JoeTouchman/JoebotHand/hardware/forearm_v3.stl

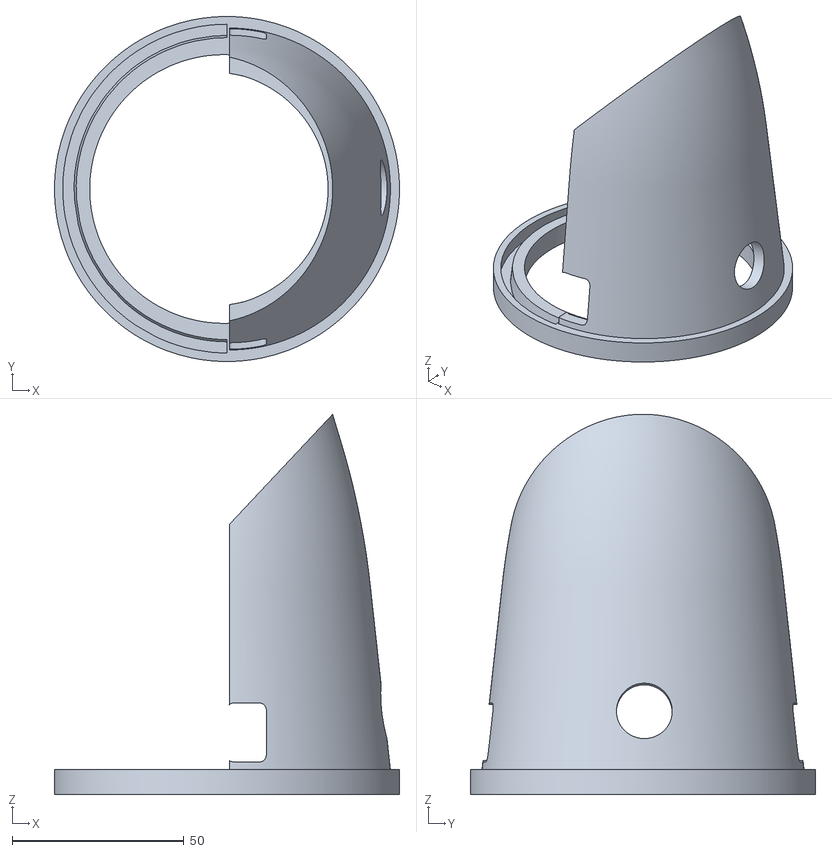
[picture p8: CAD file, 2026-11-10]
hardware/forearm_v3.stl
100.3 x 100.3 x 110.6
