JoeTouchman/JoebotHand/(commit log)

2026-09-15 Uno robotic hand: servo sketch, Python controllers, calibration
    Original Arduino Uno version of the hand. hand_servos.ino drives five
    servos from a line-based serial protocol; hand_control.py (Qt, webcam
    tracking, rock-paper-scissors) and hand_control_web.py (browser sliders)
    control it; hand_cal.json holds per-finger calibration; and
    hand_landmarker.task is the MediaPipe hand model the tracking uses.
2026-09-15 Port the hand to an ESP32-S3 with phone control over WiFi
    - esp32_test: toolchain check for the ESP32-S3 DevKitC-1 (N16R8).
    - hand_servos_esp32: five servos on GPIO 4/5/6/7/15 driven directly with
    the core's LEDC PWM (14-bit, 544-2400 us). ESP32Servo 3.2.1 routes
    several servos to the same MCPWM output on the S3, so it isn't used.
    - One FingerCal table (open/closed servo angle per finger, from measured
    dead zones). Every move goes through setFinger(), which clamps to the
    calibrated range.
    - Startup animation, replayable with "A".
    - SoftAP "JOES-HAND" serving data/index.html from LittleFS, with a
    websocket at /ws (five comma-separated percentages, ~30 Hz) and a 2 s
    watchdog that o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
2026-09-15 Add browser hand-tracking dev harness
    tracking/hand_tracking.html runs MediaPipe HandLandmarker (tasks-vision
    1.0.1, WASM) on the webcam and turns each finger into a 0.0-1.0 curl
    value. Not connected to the ESP32 yet.
    - Curl comes from joint angles on the 3D world landmarks, so it doesn't
    change with camera distance or hand rotation. Fingers: MCP flexion
    (sideways spread projected out) + PIP + DIP. Thumb, handled
    separately: MCP + IP bend + the metacarpal's angle across the palm.
    - Per-finger open/curled calibration sliders with "= now" capture,
    raw angle and per-joint breakdown shown next to the normalized value.
    - Tunable EMA smoothing, raw and smoothed bars side by side.
    - FPS an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
2026-09-15 Stream tracked finger curls to the hand over its websocket
    The tracking harness can now drive the hand: it connects to
    ws://192.168.4.1/ws and sends the smoothed curls in the phone UI's
    format (five integers 0-100). The firmware is unchanged.
    - Connect/Disconnect button; no auto-connect. Reconnects with backoff
    (0.5 s doubling to 8 s) and a 3 s connect timeout.
    - One send tick every 33 ms (30 Hz max) that reads the newest values.
    A frame is dropped rather than queued while the previous one is still
    in flight, so no backlog can build.
    - Tracking lost (no result in the last 250 ms) sends nothing, and the
    ESP32 watchdog opens the hand after 2 s.
    - "Live" toggle (Space) freezes the hand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
2026-09-16 Serve the web app from the hand over HTTPS, with camera and sliders
    The page now comes from the ESP32 itself over TLS, so one origin covers
    both needs: the camera only works on a secure page, and a secure page can
    only open a secure websocket. Servo code and calibration are untouched.
    - web/index.html: one app with a Sliders mode (nothing heavy loads) and a
    Camera mode that streams tracked finger curls, Joebotics themed, phone
    first. Animated splash, and a progress loader for the ~9 MB of tracking
    files. It downloads those itself and hands MediaPipe the bytes (blob
    URLs + modelAssetBuffer): Chrome caches nothing on a page with a
    certificate warning, so letting MediaPipe fetch them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
2026-09-16 Add all-finger presets, drop the header icon
    - Sliders mode gets "All open", "Half" and "All closed" buttons; they are
    greyed out in camera mode, where tracking drives the sliders.
    - The header is the JOEBOTICS wordmark alone; the hand mark next to it is
    gone (the animated hand in the splash and loader stays).
2026-09-16 Load the TLS certificate from flash, and answer the hand's own name
    Groundwork for hand.joeprojects.com with a real Let's Encrypt certificate,
    so phones get no warning (which is also what lets the service worker run).
    - The TLS certificate and key are read from /private/ in LittleFS when they
    are there, falling back to the self-signed pair compiled in. Renewing a
    90-day certificate is then just upload_fs.sh, with no firmware rebuild.
    - The web server refuses to serve anything under /private/, so the key
    can't be fetched over http.
    - upload_fs.sh copies certs/live/{cert,key}.pem into the image and prints
    the certificate's subject and expiry.
    - The DNS responder answers hand.joeprojec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
2026-09-16 Fix sliders needing a wake-up, add a limp button and auto-limp
    - The sliders did nothing until the animation or camera had run once. The
    page waits for the hand to report its position before sending (so a stale
    page can't yank the fingers), and the firmware sent that position from
    inside the websocket handshake - which goes out before the handshake
    response, so the browser never saw it. It is now sent from
    scanWsClients() once the socket is really a websocket. The page also
    sends as soon as you move something yourself, whether or not the position
    arrived.
    - Limp button under the sliders: stops the servos holding a pose. The
    firmware now accepts "R" over the websocket, and cle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
    [hand_servos_esp32.ino]
2026-09-16 Add the passive buzzer on GPIO 17
    Driven straight from LEDC on a channel asked for by number (5) rather than
    tone(), so it can't collide with the servos on 0-4. The core assigns timers
    by frequency and resolution, so the buzzer's 2 kHz / 10-bit channel lands on
    a different timer than the servos' 50 Hz / 14-bit; boot prints the channel
    and timer next to the five servo channels.
    - Note tables at the top of the file: boot chirp (rising two-note), done
    (double-beep), client (falling blip). Each note is 60-90 ms.
    - State machine stepped from loop(); no delay() anywhere in it. Volume is a
    duty-cycle constant, currently 25%.
    - The animation is now queued: the chirp plays first and the fingers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
    [hand_servos_esp32.ino]
2026-09-16 Make the buzzer louder: tune to the piezo's resonance, full duty
    The boot chirp was the quietest sound because it sat lowest. A passive
    piezo peaks near its resonance (usually ~4 kHz) and falls off steeply
    below it, so 1175/1568 Hz was well down the slope while the 1976 Hz done
    beep was closer to the peak.
    - Tones moved up: chirp 3136 -> 4186 Hz, done beep 4186 Hz, client blip
    4186 -> 3136 Hz.
    - BUZZER_VOLUME 25 -> 50% duty, the most a square wave delivers.
    - New "B3" sound sweeps 1-5 kHz in 500 Hz steps, and "B<freq>" (100 or
    more) holds that frequency for 400 ms, so the real peak of this piezo
    can be found and the tables tuned to it.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
    [hand_servos_esp32.ino]
2026-09-16 Add the status LED on GPIO 16
    The switch's LED ring, common anode to 5V with an S8050 NPN sinking the
    cathode. LEDC channel 6 at 5 kHz, 12-bit: the resolution differs from the
    buzzer's 10-bit on purpose, so the core gives it its own timer instead of
    sharing the buzzer's and dragging the LED's frequency along with every note.
    Breathes on a 2 s raised cosine with no client connected, goes solid when
    one is, and double-blinks when the startup animation finishes. All of it is
    stepped from loop() off millis(); no delay() anywhere.
    printChannelMap() lists all seven LEDC peripherals with their channel, timer,
    frequency and resolution, and flags a shared channel or a doubled-up pin.
    Verified on ha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
    [hand_servos_esp32.ino]
2026-11-10 Reorganize the repo into firmware, web, tracking and desktop
    - firmware/esp32_hand: the main ESP32-S3 firmware (was ESP32/hand_servos_esp32)
    - firmware/uno_hand_v1: the original Arduino Uno sketch (was hand_servos)
    - firmware/diagnostics: bring-up and ESP32Servo debugging sketches
    - desktop: the Python control panels, calibration and the USB test tool
    Fixes the Uno sketch not compiling: an ESP32 test file sat in the same
    sketch folder, giving it two setup() and loop() functions. It duplicated
    diagnostics/esp32_test, so it's removed. Also fixes hand_control_web.py
    telling you to run hand_control.py.
    The 7.8 MB hand landmark model is no longer committed: fetch_vendor.sh
    downloads it into tra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
    [channel_report.ino, esp32_hand.ino, esp32_test.ino, finger_test.py, hand_control.py, hand_control_web.py, pin_sweep_test.ino, servo_test.ino]
2026-11-10 Add a README draft, MIT license and diagnostics notes
    The README covers what the hand does, how the tracking and firmware fit
    together, credits for the base hand design, and how to build it. Sections
    marked TODO are waiting on photos, video and hardware files.
    firmware/diagnostics/README.md explains each test sketch and the
    ESP32Servo routing bug they tracked down. desktop/requirements.txt lists
    the Python dependencies.
2026-11-10 Add demo GIFs to the README
    Hero GIF of the hand copying a tracked hand, the startup animation, slider
    control, and the servos inside the forearm. Compressed from the raw clips
    (97 MB) to 18.6 MB total: 12-15 fps, 560-640 px wide. The raw clips stay
    in the gitignored media_drop/ folder.
    Also includes my own wording edits to the README intro.
2026-11-10 Add a wiring diagram to the README
    Shows the 5 V 5 A supply through the screw terminal and power switch to
    the breadboard rails and 1000 uF capacitor, the ESP32-S3 and five servos
    with their GPIO pins, the status LED's transistor driver and the buzzer.
2026-11-10 Redraw the wiring diagram as a schematic
    KiCad-style: standard symbols, reference designators, pin numbers from
    the DevKitC-1 J1 header, power and ground flags, and net labels naming
    each finger's servo signal.
2026-11-10 Add the forearm STL, number the forearm photo, resize images
    The version 3 forearm STL goes in hardware/, with a rendered preview in
    the README that opens GitHub's 3D viewer. The forearm photo is numbered
    1-3, it and the schematic now match the GIFs' width, and the app
    screenshot gets a border and spacing from the text. Also includes my
    own AI-assistance note.
    [forearm_v3.stl]
2026-11-10 Caption the forearm render with a link to its STL
    Also includes my wording edits to the forearm iteration list.
2026-11-10 Explain the HTTPS certificate work in the engineering challenges
    Also includes my wording edits to the highlights and the servo bug.
2026-11-10 Redraw flowchart
2026-11-10 White flowchart lanes
